Stephen-Arsenault/DRAM-Liberator/Schematics/HI-RES__DRAM Liberator Schematics.jpg

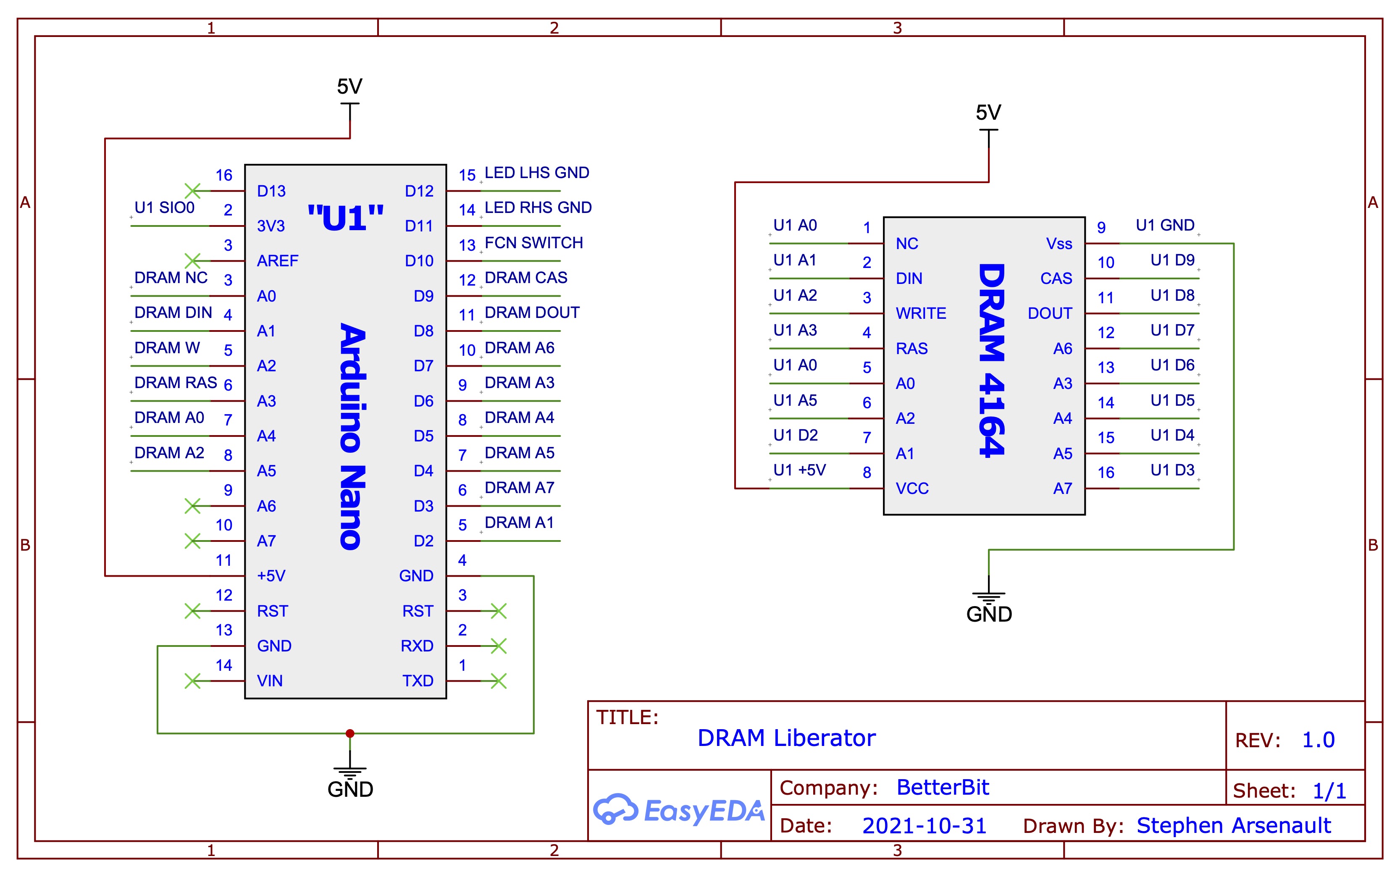
Schematics/HI-RES__DRAM Liberator Schematics.jpg
