Stephen-Arsenault/DRAM-Liberator/Schematics/DRAM Liberator Schematics.pdf

5V

"U1"

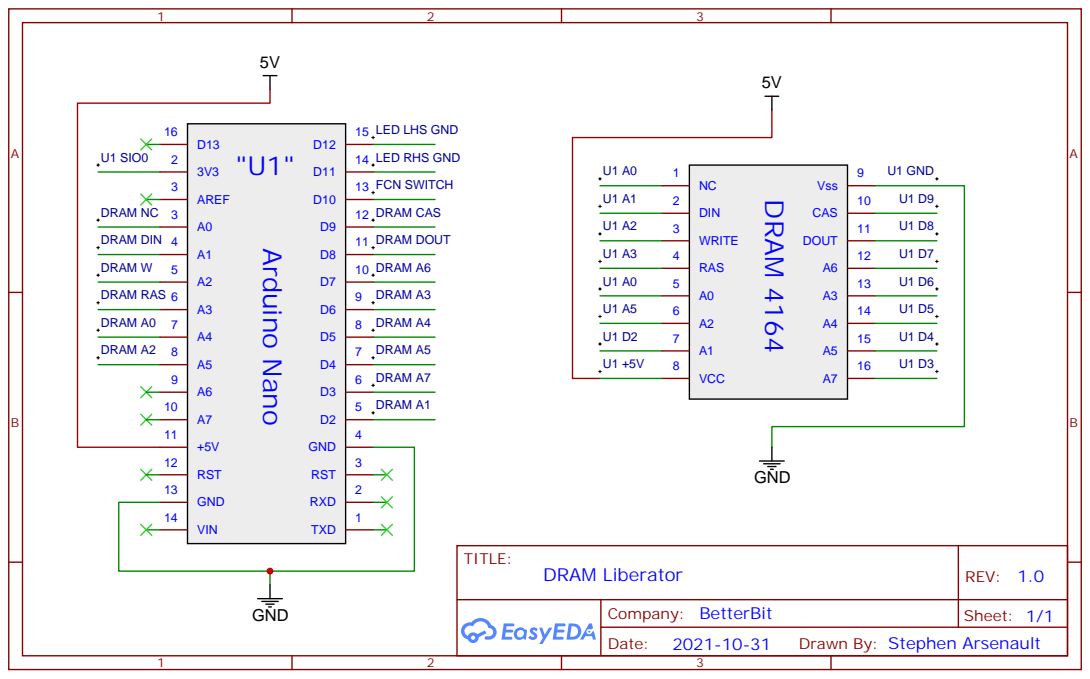
[picture p6: page 1]

Drawn By: Stephen Arsenault
