Stephen-Arsenault/DRAM-Liberator/(commit log)

2021-07-18 Update arduino.ino
    Updated XA8 Mapping from A6 to 14 in order to correspond with Gerbers.
2021-10-31 Added Schematics
2021-11-02 Updated schematics
2021-12-16 Assembly Photos
